bnkutler/mickeymiles/reference/mickey/IMG_6343.jpeg

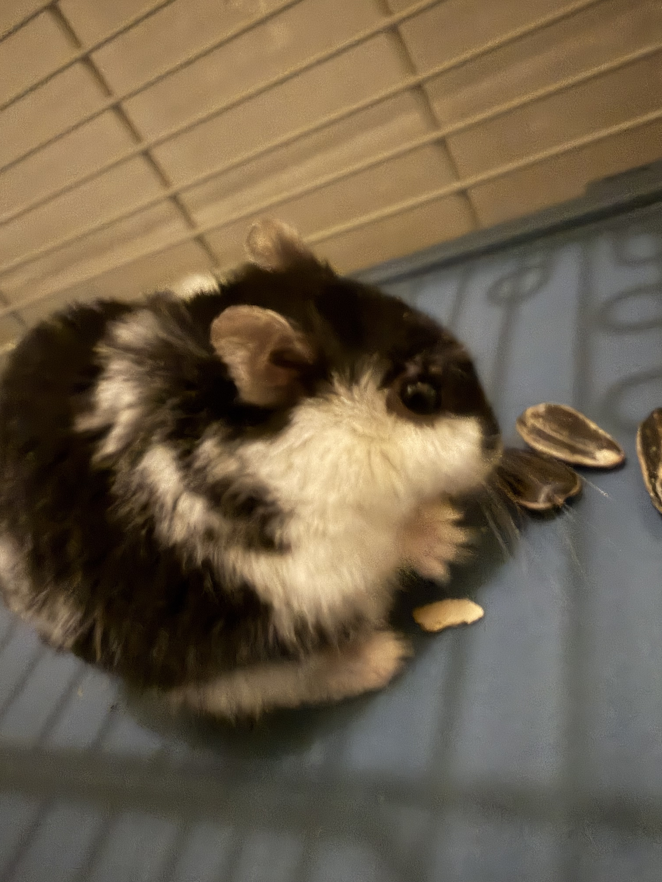
reference/mickey/IMG_6343.jpeg
