bnkutler/mickeymiles/reference/mickey/IMG_6212.jpeg

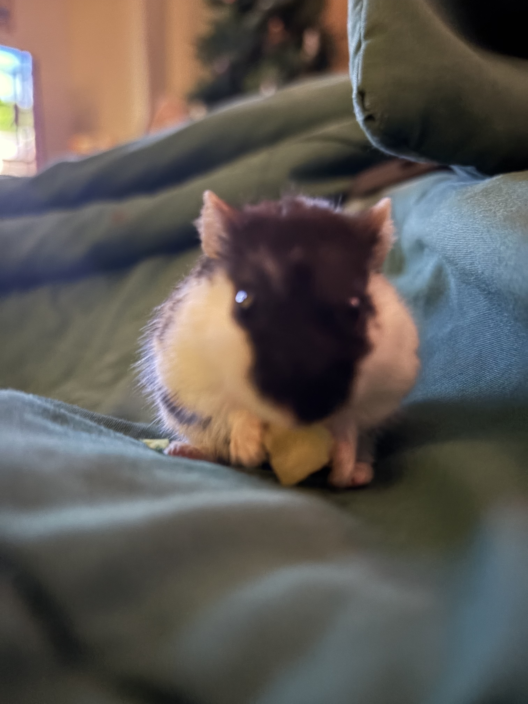
reference/mickey/IMG_6212.jpeg
