bnkutler/mickeymiles/design_handoff_idle_clicker_redesign/Status Screen Redesign.dc.html

Turn 3 · low-detail scrollable trail map + Friends & Fam (3b setup / 3c home)

# Trail Map & Friends & Fam

3a · Trail Map

STATUS

LOG

TRAIL

FRIENDS

3b · Friends — Set Up

JOIN THE TRAIL CREW

Pick a name and build your pixel self.

Name

◀ HAIR / HAT ▶

◀ SKIN ▶

◀ OUTFIT ▶

CHECK IN ✓

3c · Friends — Home

HEY, TRAILHEAD!

One powerup per day, resets at midnight.

PICK TODAY'S POWERUP

{{ p.label }} {{ p.multiplier }}x Miles {{ p.duration }} min

🎒 Pack it in Mickey's Backpack

ON THE BLEACHERS

{{ f.name }}

STATUS

LOG

TRAIL

FRIENDS

Turn 2 · refining 1b Retro Arcade — bigger HUD, pixel icons, in-place run, Log & Trail screens

# Retro Arcade — Status, Log & Trail

Demo state: 🏃 Running 🍽️ Refuel 😴 Sleeping 💚 Love

2a · Status

● LIVE

BIG BEAR LAKE

{{ speedLabel }}

MPH · {{ milesLabel }} MI

STATUS

LOG

TRAIL

FRIENDS

2b · Daily Log

{{ journeyTotals.total }}

TOTAL MI

{{ journeyTotals.trueMiles }}

TRUE MI

{{ journeyTotals.left }}

MI LEFT

DAILY LOG

{{ row.date }} {{ row.miles }} MI {{ row.time }} {{ row.speed }} mph

actual {{ row.actualLabel }} mi +{{ row.bonusLabel }} mi powerup

🏔 {{ row.milestone }}

STATUS

LOG

TRAIL

FRIENDS

2c · Trail

● LIVE

BIG BEAR LAKE

{{ journeyTotals.left }}

MI TO CANADA

BIG BEAR LAKE

San Bernardino Mountains · mile 265

{{ node.name }} mi {{ node.mile }}

STATUS

LOG

TRAIL

FRIENDS

Turn 1 · explore

# Mickey Miles — Idle-Clicker Status Screen

Demo state: 🏃 Running 🍽️ Refuel 😴 Sleeping 💚 Love

1a · Cozy & Cute

📍 Big Bear Lake

{{ speedLabel }} MPH

{{ milesLabel }} mi today

💚

⚡

🎒

🐹

📋

🗺️

👥

1b · Retro Arcade HUD

● LIVE

{{ speedLabel }}

MPH · {{ milesLabel }} MI

💚

⚡

🎒

STATUS

LOG

TRAIL

FRIENDS

1c · Candy & Cartoony

📍 Big Bear Lake

{{ speedLabel }} MPH

{{ milesLabel }} mi

💚

⚡

🎒

🐹

📋

🗺️

👥
