bnkutler/mickeymiles/reference/mickey/IMG_5748.jpeg

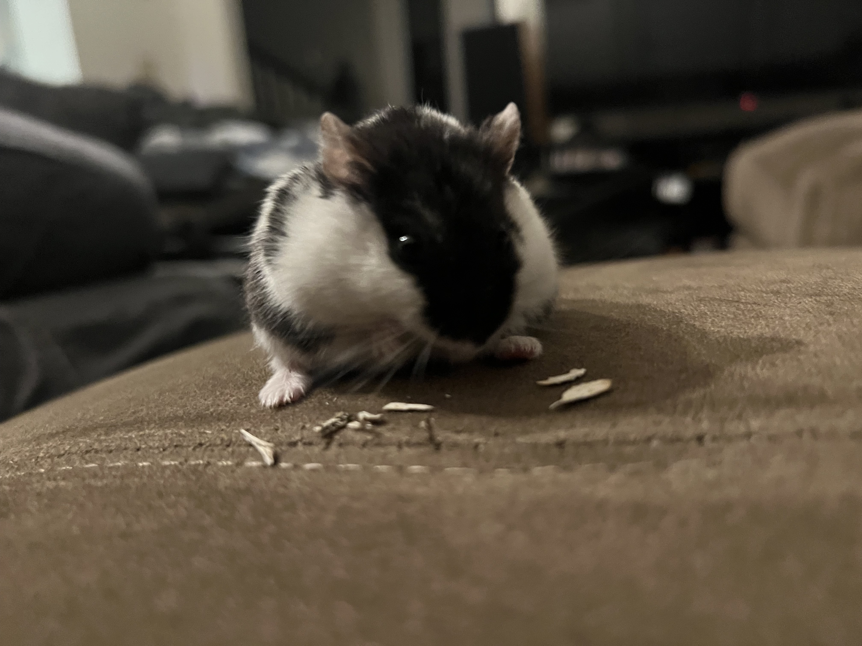
reference/mickey/IMG_5748.jpeg
