bnkutler/mickeymiles/reference/mickey/IMG_6283.jpeg

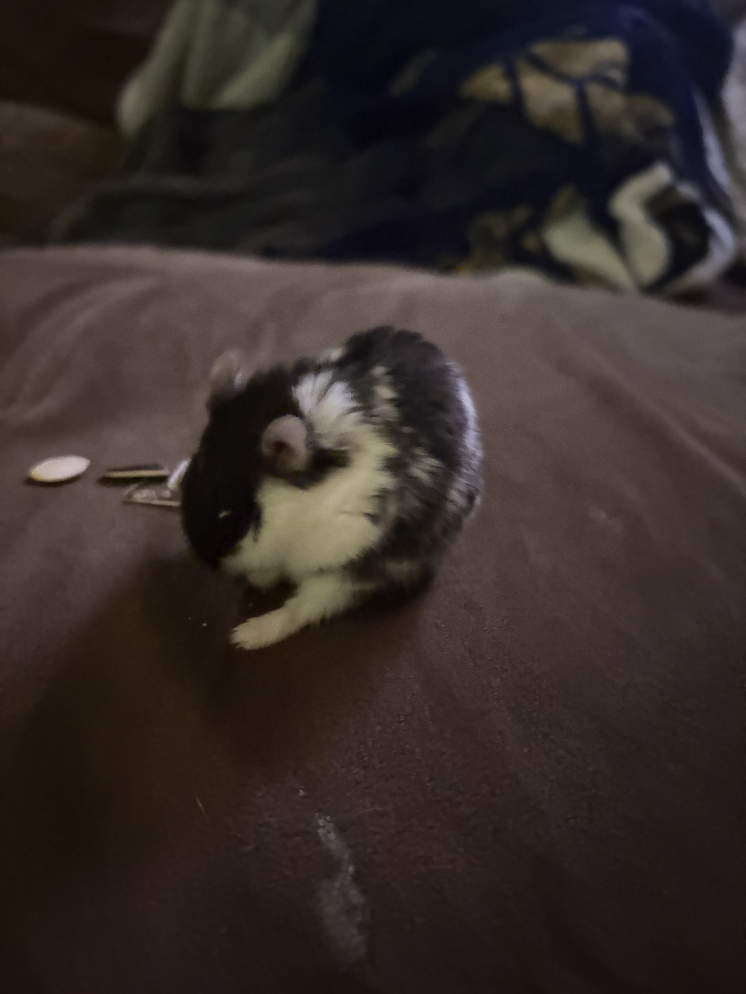
reference/mickey/IMG_6283.jpeg
