bnkutler/mickeymiles/(commit log)

2026-03-26 Set up Mickey Miles v1 tracker stack.
    Add ESP32 firmware, backend API, and frontend live polling integration so Render can host the backend and the UI can show real telemetry.
    Made-with: Cursor
2026-07-12 Redesign Mickey Miles into the live PCT tracker (frontend + backend)
    - Retro-arcade full-bleed UI: Status / Daily Log / Trail map / Friends,
    animated pixel Mickey (run/refuel/sleep), powerups, backpack, presence
    - Node/Express + SQLite backend: telemetry ingest, users, powerup redeem +
    gifting, love, eating/boost timing, presence; dev tools gated by MICKEY_DEV
    - Firmware: median-of-6 speed smoothing (no more single-rev jitter)
    - Render blueprint, green favicon, PWA manifest + service worker
    - Block server/firmware/reference/design_handoff from static serving
    [mickey_tracker.ino]
2026-07-12 Pin NODE_VERSION to 22.11.0 for reliable better-sqlite3 install on Render
2026-07-14 Phone fills mobile screen, ephemeral profiles + per-device powerup cap, snappier speed
    - Full-bleed on phones (<=600px); scaled device frame on desktop; canvas
    resolution tracks the real screen aspect so pixel art fills without stretch
    - Profile is rebuilt every visit (not persisted); one-powerup-per-day is now
    enforced per browser via a stable device id (survives the profile reset)
    - Loosen speed smoothing: backend window 18s->6s, firmware median 6->4 with a
    heavier weight on new readings, so MPH ramps up and tracks the real wheel
    - Sleep note uses the readable VT323 font
    [mickey_tracker.ino]
2026-07-14 Presence-on-close, roomier check-in, more avatars, name filter, taller Mickey
    - Leave the spectating bench immediately on tab close (sendBeacon -> /api/leave);
    presence fallback window tightened to 45s
    - Compact the check-in setup so the CHECK IN button fits without scrolling
    - Rename SKIN -> SKIN COLOR
    - Add hair (Ponytail, Mohawk) and outfit options incl a Mickey-face "Mickey Tee"
    - Mickey-friendly name filter: first bad name asks nicely, repeats warn
    "BK and Mickey are disappointed, don't get banned!"
    - Taller refuel Mickey so he sits upright instead of smooshed flat
2026-07-14 Hourly snacks + "Mickey ate it" status; triangle mohawk; grey Mickey Tee
    - One gifted snack per browser per hour (was per day); friendly cooldown copy
    - Friends page shows "Mickey has eaten the snack you gave him!" once eaten,
    and a "Next snack in Nm" countdown on the pack button
    - Track gift ownership by device so we know whose snack was eaten
    - Mohawk is now a triangular crest; Mickey Tee uses a light-grey shirt
    - (No firmware change — miles math verified correct: distance = pulses ×
    wheel_circumference / flags_per_rev)
2026-08-16 Reject phantom wheel pulses; add a daily-log repair tool
    From Jul 31 to Aug 6 the log banked ~1,900 miles that Mickey never ran, at a
    suspiciously steady ~337 mi/day. The daily totals give the cause away: they
    imply 19.998-20.001 Hz for five days straight. A 120 Hz light source (mains
    ripple) was reaching the slot sensor, and the ISR's 45 ms debounce quantises
    an 8.333 ms flicker to exactly 6 periods -- 50.000 ms, or 20.000 Hz. It read
    as ~15.6 mph, just under the firmware's 25 mph reject, and the backend
    trusted whatever the device sent.
    Backend: sanity-check telemetry before it reaches the log. Deltas implying
    more than 6 mph since the last report are dropped, wheel time cannot exceed
    the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
2026-08-16 Stack powerups, burn them on run time, and fix wheel-time accounting
    HUD: the speed readout keeps its unit on the same line. Stacked "MPH" cost a
    whole line on a phone for the one number you glance at.
    Powerups now stack. A new gift no longer replaces the one in effect -- every
    live powerup contributes. Bonuses add rather than compound, so 2x and 5x give
    6x (1 + 1 + 4); six stacked chillies compounding would be a million-x and end
    the trail in an afternoon. combinedMultiplier() is the one place to change if
    compounding is wanted instead.
    Their timers also burn run time rather than wall-clock time, so a powerup
    gifted while Mickey sleeps is still whole when he wakes up. remainingMs is
    decre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
    [mickey_tracker.ino]
2026-08-16 Compound stacked powerups up to 100x; retune durations for run time
    Stacked powerups now multiply rather than sum, so a 2x and a 5x give 10x. The
    product is clamped to MAX_COMBINED_MULTIPLIER (100) so a backpack of chillies
    can't run away with the trail -- three would otherwise be 1000x. The HUD chip
    shows "100X MAX" when the clamp is actually biting, so it's clear that adding
    another snack won't help.
    Durations are retuned for the run-time clock, sized against Mickey's ~20 wheel
    -minutes a night: pumpkin seed 2x/12 min, blueberry 5x/3 min, chili 10x/90 s.
    That is ~0.19 bonus miles each at his usual 0.95 mph -- deliberately close in
    value, differing in shape rather than payout: the seed is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
    [t3_rev_count.ino]
